SAMAH-AHMED1ki/Project_Tank_NTI/Simulation Screenshot/Screenshot 2026-09-17 232238.png

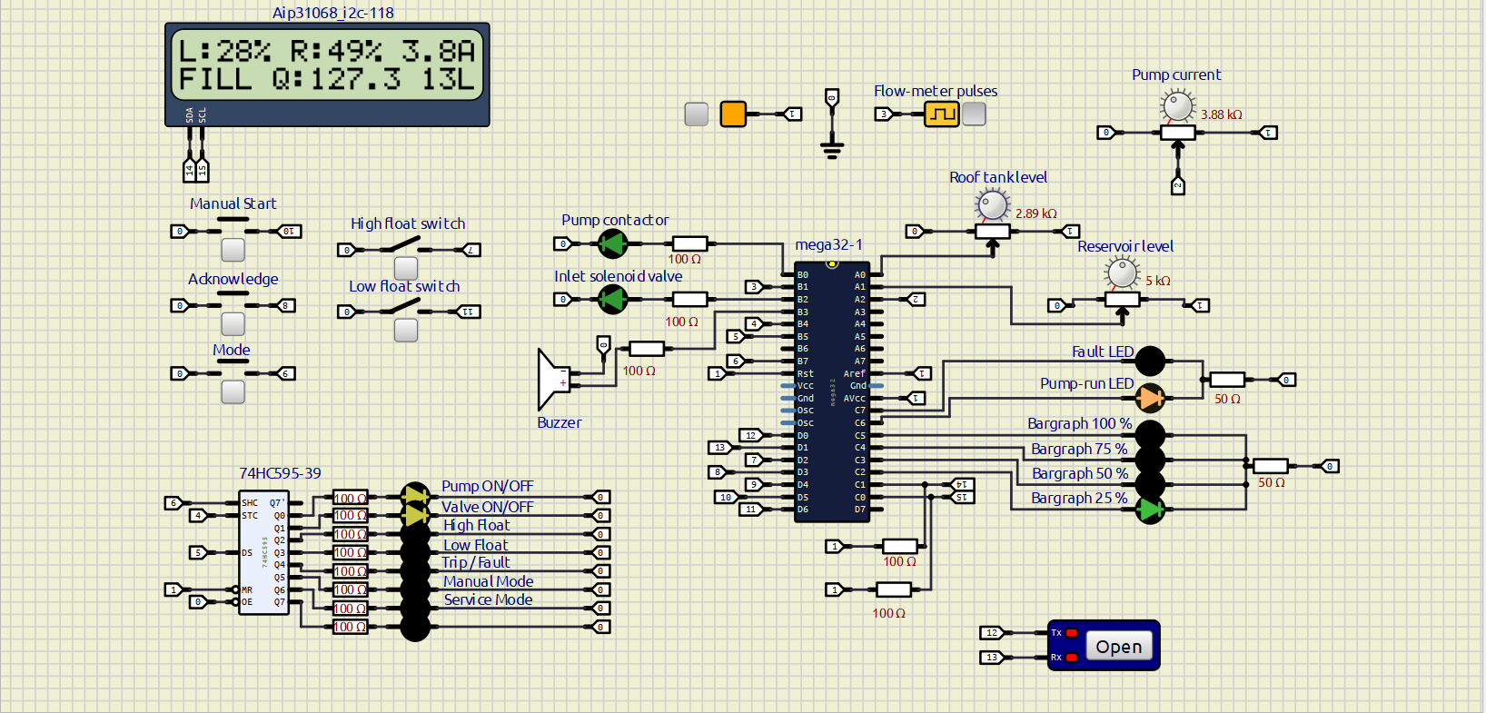
Simulation Screenshot/Screenshot 2026-09-17 232238.png
