SAMAH-AHMED1ki/Project_Tank_NTI/(list of files, drawings)

Other design files:
Smart_Water_Tank_Controller (2).sim1
