SAMAH-AHMED1ki/Project_Tank_NTI/MCAL/ADC/ADC_private.h

#ifndef ADC_PRIVATE_H
#define ADC_PRIVATE_H

/*
 * Author: Ahmed Ellamie
 * Email:  ahmed.ellamiee@gmail.com
 *
 * STUDENT TASK — ADC private layer (ATmega32)
 * Include this file ONLY from ADC.c.
 *
 * What you must add here:
 * 1. Register-address macros (I/O space):
 *      ADMUX   0x27    REFS1 REFS0 ADLAR MUX4..MUX0
 *      ADCSRA  0x26    ADEN  ADSC  ADATE ADIF ADIE ADPS2..0
 *      ADCH    0x25
 *      ADCL    0x24    — always read ADCL first, then ADCH
 *
 * 2. Bit-position macros used by ADC.c:
 *      ADMUX  : REFS1=7, REFS0=6, ADLAR=5
 *      ADCSRA : ADEN=7, ADSC=6, ADATE=5, ADIF=4, ADIE=3, ADPS2=2, ADPS1=1, ADPS0=0
 *
 * 3. A helper that builds ADMUX from reference + channel without touching
 *    the rest of the chip, for example:
 *      ADMUX = (ref << 6) | (channel & 0x1F)
 *
 * 4. Keep channel range 0..7 and reject anything else in ADC.c.
 */

/* ADC registers and bit positions in the ATmega32 I/O space. */
#define ADC_ADMUX  (*(volatile uint8 *)0x27)
#define ADC_ADCSRA (*(volatile uint8 *)0x26)
#define ADC_ADCH   (*(volatile uint8 *)0x25)
#define ADC_ADCL   (*(volatile uint8 *)0x24)

#define REFS1 7
#define REFS0 6
#define ADLAR 5

#define ADEN  7
#define ADSC  6
#define ADATE 5
#define ADIF  4
#define ADIE  3
#define ADPS2 2
#define ADPS1 1
#define ADPS0 0
#endif /* ADC_PRIVATE_H */
