SAMAH-AHMED1ki/Project_Tank_NTI/MCAL/TIMER/TIMER_interface.h

#ifndef TIMER_INTERFACE_H
#define TIMER_INTERFACE_H

/*
 * Author: Ahmed Ellamie
 * Email:  ahmed.ellamiee@gmail.com
 *
 * MCAL TIMER — simple API for ATmega32 Timer0 and Timer1 at F_CPU = 8 MHz.
 *
 * Include this header from HAL, Logic, and main.
 * Do not include TIMER_private.h there — registers and bit numbers stay inside
 * TIMER.c, together with the static helpers only that file needs.
 *
 * Pins : OC0 = PB3 (Timer0 PWM) , OC1A = PD5 (Timer1 PWM).
 *        Make the pin an output with GPIO before you expect a wave on it.
 *
 * Delays here are blocking, like _delay_ms, but timed by the hardware counter
 * instead of a software loop.
 */

#include "STD_TYPES.h"

/*========================== Timer0 — 8-bit ==========================*/

/*
 * Description : Prepare Timer0 for the delay functions (1 ms tick).
 *               Call it once before TIMER0_DelayMS or TIMER0_DelayS.
 */
STD_ReturnType TIMER0_Init(void);

/*
 * Description : Block for Copy_u16Milliseconds (1 .. 65535 ms), then return.
 */
STD_ReturnType TIMER0_DelayMS(uint16 Copy_u16Milliseconds);

/*
 * Description : Block for Copy_u16Seconds seconds, then return.
 */
STD_ReturnType TIMER0_DelayS(uint16 Copy_u16Seconds);

/*
 * Description : Output a ~490 Hz PWM wave on OC0 (PB3) and leave it running.
 *               Configures the timer itself, so TIMER0_Init is not needed first.
 * Parameter   : Copy_u8DutyPercent — 0..100.
 * Return      : E_OK, or E_NOK above 100.
 */
STD_ReturnType TIMER0_PWM(uint8 Copy_u8DutyPercent);

/*
 * Description : Stop Timer0 and release OC0 (PB3) back to plain GPIO.
 */
STD_ReturnType TIMER0_Stop(void);

/*========================== Timer1 — 16-bit ==========================*/

/*
 * Description : Prepare Timer1 for the delay functions (1 ms tick).
 */
STD_ReturnType TIMER1_Init(void);

/*
 * Description : Block for Copy_u16Milliseconds (1 .. 65535 ms), then return.
 */
STD_ReturnType TIMER1_DelayMS(uint16 Copy_u16Milliseconds);

/*
 * Description : Output PWM on OC1A (PD5) at a frequency you choose, and leave
 *               it running. Configures the timer itself.
 * Parameters  : Copy_u16FrequencyHz — 16 .. 20000 Hz. Servos use 50.
 *               Copy_u8DutyPercent  — 0..100.
 * Return      : E_OK, or E_NOK for a frequency out of range or duty above 100.
 */
STD_ReturnType TIMER1_PWM(uint16 Copy_u16FrequencyHz, uint8 Copy_u8DutyPercent);

/*
 * Description : Stop Timer1 and release OC1A (PD5) back to plain GPIO.
 */
STD_ReturnType TIMER1_Stop(void);

/*===================== Timer1 — External Counter =====================*/

/*
 * Configure Timer1 to count external pulses on T1/PB1.
 * Counting occurs on rising edges.
 */
STD_ReturnType TIMER1_ExternalCounterInit(void);

/*
 * Return the current number of counted pulses.
 */
uint16 TIMER1_GetCounter(void);

/*
 * Reset the external pulse counter.
 */
STD_ReturnType TIMER1_ResetCounter(void);

#endif /* TIMER_INTERFACE_H */
