SAMAH-AHMED1ki/Project_Tank_NTI/(commit log)

2026-09-13 Add initial AVR_NTI project files and build scripts
    - Created main.c for the AVR_NTI application entry point, implementing GPIO and timer functionalities.
    - Added Makefile.template to facilitate project building with AVR-GCC, including source file discovery and compilation rules.
    - Introduced avr-build.ps1 for building the project, verifying toolchain installation, and ensuring project structure.
    - Implemented avr-init.ps1 for setting up the AVR toolchain, adding it to the system PATH, and creating necessary project directories.
2026-09-13 Add detailed driver plan and team assignment to project documentation
2026-09-13 Refactor ADC function prototypes for clarity and consistency
2026-09-13 Refactor project documentation to clarify existing drivers and their statuses
2026-09-14 Implement SPI driver functions and update project documentation
2026-09-14 Remove 'common' module entry from the existing drivers list in project documentation
2026-09-14 Refactor UART and SPI modules; add Shift Register functionality
    - Updated UART.c with improved code structure and readability.
    - Enhanced UART functions: UART_Init, UART_SendByte, UART_ReceiveByte, UART_SendString, UART_IsDataReady, UART_SetRxInterrupt, UART_SetTxInterrupt.
    - Introduced SPI functions: SPI_InitMaster, SPI_InitSlave, SPI_Transceive, SPI_SelectSlave, SPI_ReleaseSlave.
    - Added Shift Register module with functions SHIFTREG_Init and SHIFTREG_SendByte for better hardware control.
    - Updated build files for new and modified modules.
2026-09-14 Add flowmeter external counter support
2026-09-14 Implement tank level sensing module with ADC integration and noise filtering
    [level.c, level_interface.h]
2026-09-14 Add current sensor and float switch HAL drivers
2026-09-14 Refine level sensing and current monitoring
2026-09-14 Fix ADC channel selection and float inputs
    [ADC.c, floats.c, floats.h, level.c]
2026-09-14 Refactor demand and interlock data flow
2026-09-14 Fix flowmeter and UART integration
    [Flowmeter.c, Flowmeter_interface.h, UART.c, main.c]
2026-09-14 Resolve UART merge artifacts
    [UART.c]
2026-09-15 Fix scheduler task readiness
    [main.c]
2026-09-15 Update I2C driver
2026-09-15 Mark I2C and display files as implemented
    Updated implementation status for I2C and display components.
2026-09-15 Refactor main.c for Timer1 external counter test
    - Removed Scheduler integration and related task for counting.
    - Implemented direct Timer1 external counter initialization and usage.
    - Updated comments to clarify the purpose and hardware setup for the test.
    - Adjusted the main loop to read pulse counts every second and display them on the LED bar.
2026-09-15 Refactor main.c to implement UART communication, add scheduler and flowmeter tests
    - Introduced UART driver functions for sending characters, strings, and numbers.
    - Added a scheduler test task to demonstrate task scheduling functionality.
    - Implemented SPI communication with a 74HC595 shift register for LED control.
    - Created timer tests for TIMER0 and TIMER1, including PWM functionality.
    - Developed a flowmeter test to measure pulses and flow rate.
    - Removed legacy timer reset and delay functions in favor of new implementations.
    - Organized code into distinct sections for clarity and maintainability.
    [main.c]
2026-09-15 Update program.map and main.c for memory alignment and timer test adjustments
    - Adjusted memory addresses in program.map to ensure proper alignment and allocation for various functions and data sections.
    - Increased delay in Test_Timer0 function from 2000ms to 3000ms for extended testing duration.
    - Added initialization for PB3 pin in main.c to ensure proper operation during TIMER0 PWM test.
2026-09-16 Resolve main rebase conflict and keep driver test app
    [lcd_i2c.c, lcd_i2c_interface.h]
2026-09-16 Update LCD I2C integration
2026-09-16 Update button driver
2026-09-16 Refactor TIMER module to configure PORTB for output and update data structures in demand and interlocks logic
2026-09-16 Update smart water tank controller
    [Smart_Water_Tank_Controller.sim1]
2026-09-16 Refactor main.c for improved readability and organization
    - Updated comments for clarity and consistency throughout the code.
    - Grouped related initialization sections for better structure.
    - Enhanced documentation for functions and tasks to reflect their purpose more clearly.
    - Removed unnecessary whitespace and adjusted formatting for better alignment.
    - Added new variables for total volume calculation and updated related logic.
    [Smart_Water_Tank_Controller.sim1]
2026-09-16 Update project state
    [Smart_Water_Tank_Controller.sim1]
2026-09-17 Update console and current monitoring
2026-09-17 Update tank controller telemetry and fault handling
    [Smart_Water_Tank_Controller (2).sim1]
2026-09-17 Fix current reporting and fault acknowledgment
    [console.c, tank_fsm.c]
2026-09-18 Initial project import
    [Smart_Water_Tank_Controller (2).sim1]
